0x1ea7bee5/defcon_badge_2026/defcon_badge_main/defcon_badge_main.stl

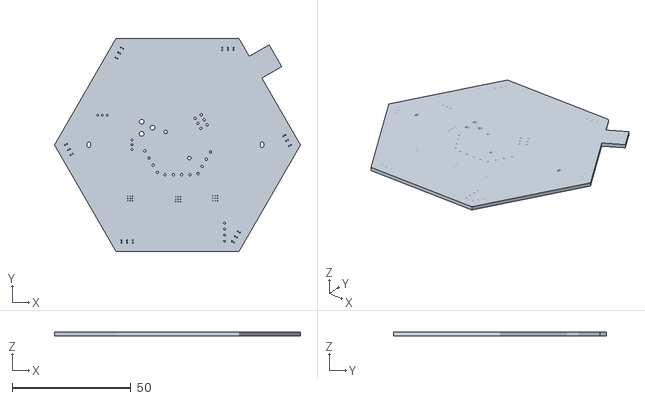
[picture p1: CAD file, 2026-06-07]
defcon_badge_main/defcon_badge_main.stl
103.5 x 89.6 x 1.51
