0x1ea7bee5/defcon_badge_2026/external_footprints/1043P/1043P.step

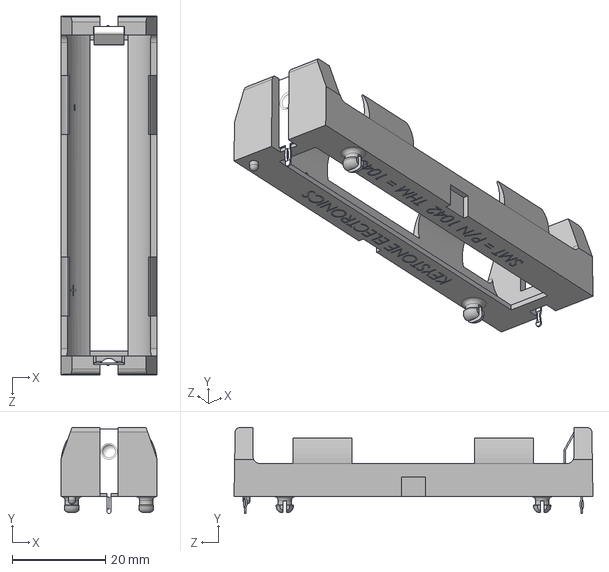
[picture p2: CAD file, 2026-02-23]
external_footprints/1043P/1043P.step
20.7 x 18.5 x 77.1 mm
