0x1ea7bee5/defcon_badge_2026/external_footprints/BK-18650-PC2/BK-18650-PC2.step

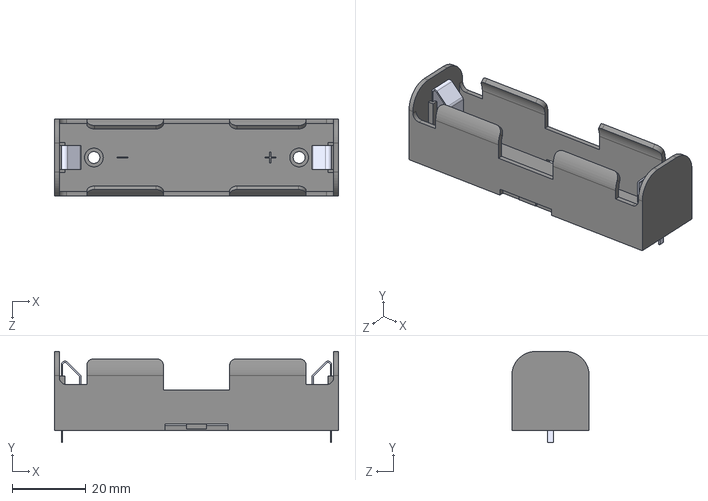
[picture p3: CAD file, 2026-03-09]
external_footprints/BK-18650-PC2/BK-18650-PC2.step
77.0 x 24.7 x 21.0 mm
