0x1ea7bee5/defcon_badge_2026/external_footprints/DRIVER-A4988SETTR-T_QFN28_/DRIVER-A4988SETTR-T_QFN28_.step

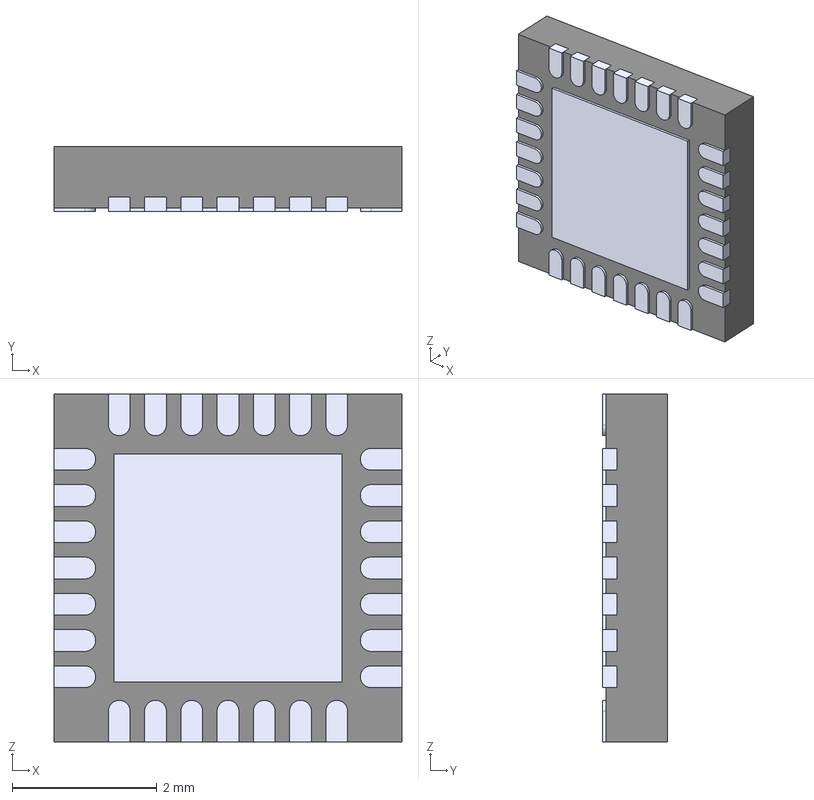
[picture p4: CAD file, 2026-02-22]
external_footprints/DRIVER-A4988SETTR-T_QFN28_/DRIVER-A4988SETTR-T_QFN28_.step
4.80 x 0.9 x 4.80 mm
Body_Solid1
Body001_Solid1
Array_Solid1 x 7
Array001_Solid2 x 6
Body002_Solid1
Array002_Solid1 x 7
Array003_Solid2 x 6
Body003_Solid1
Body004_Solid1
