0x1ea7bee5/defcon_badge_2026/external_footprints/ESP32-C5-WROOM-1U PCB Footprint_0.dxf

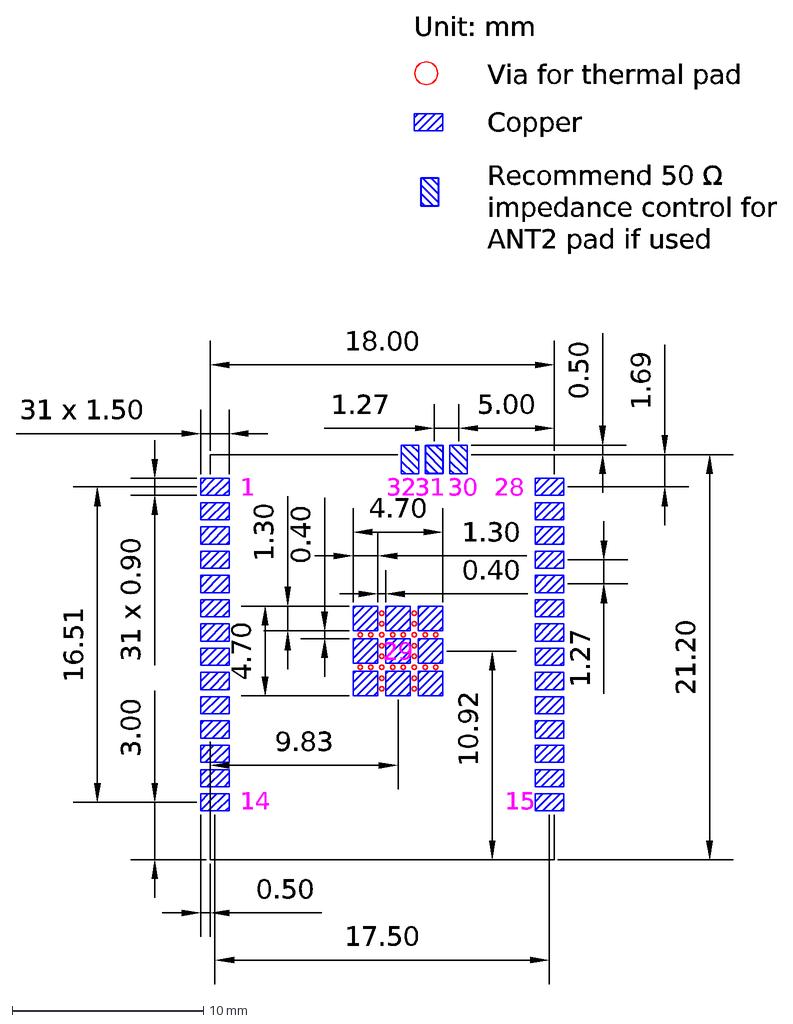
[picture p5: CAD file, 2026-02-21]
external_footprints/ESP32-C5-WROOM-1U PCB Footprint_0.dxf
1
28
Unit: mm
Copper
Via for thermal pad
14
15
1.27
31 x 1.50
31 x 0.90
3.00
16.51
17.50
1.30
0.40
4.70
18.00
0.50
9.83
10.92
30
31
32
1.69
21.20
5.00
Recommend 50 Ω impedance control for ANT2 pad if used
29
