0x1ea7bee5/defcon_badge_2026/external_footprints/SS24FL/SS24FL.step

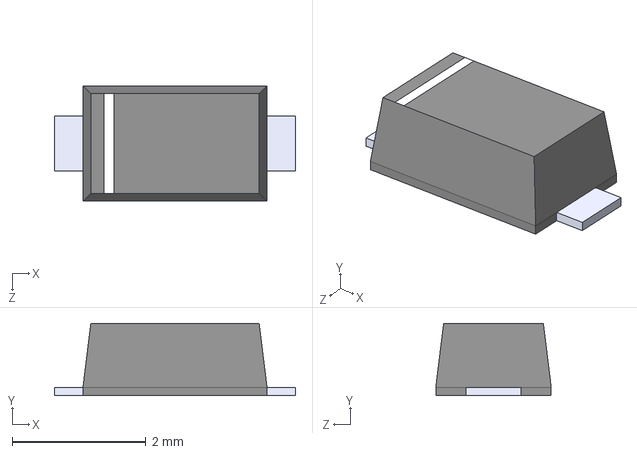
[picture p6: CAD file, 2026-02-23]
external_footprints/SS24FL/SS24FL.step
3.60 x 1.08 x 1.72 mm
