0x1ea7bee5/defcon_badge_2026/external_footprints/WCAP-ASLI_6.3X5.5/WCAP-ASLI_6.3X5.5.step

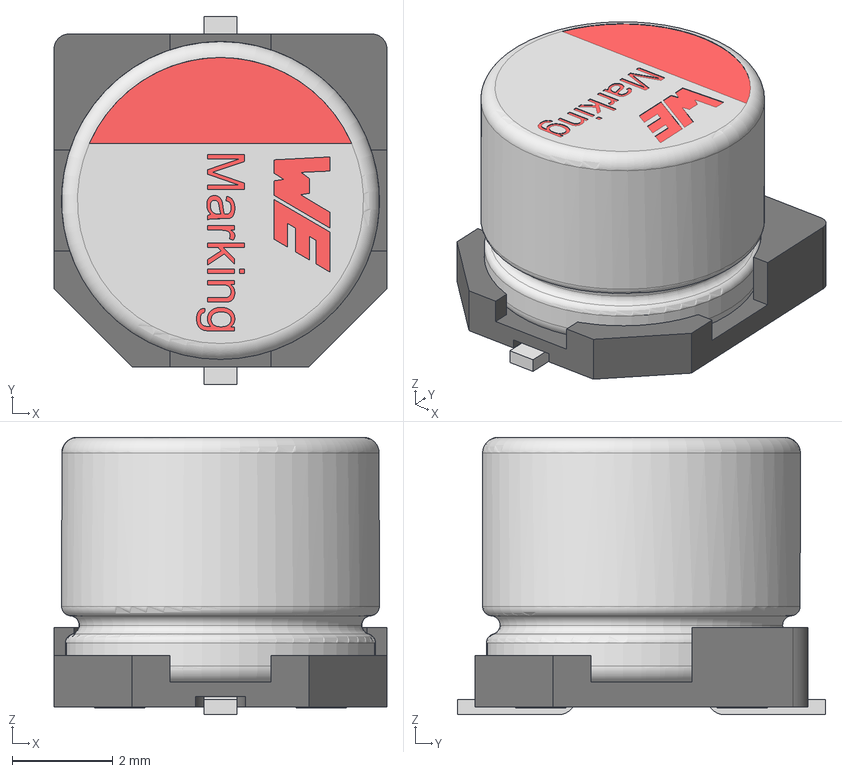
[picture p7: CAD file, 2026-02-23]
external_footprints/WCAP-ASLI_6.3X5.5/WCAP-ASLI_6.3X5.5.step
6.60 x 7.30 x 5.50 mm
capicitor_6.3x5.5x2.2
Base_Φ6_3Capacitor
