0x1ea7bee5/defcon_badge_2026/external_footprints/ESP32-C5-WROOM-1U_V1_1_20250619_0.STEP

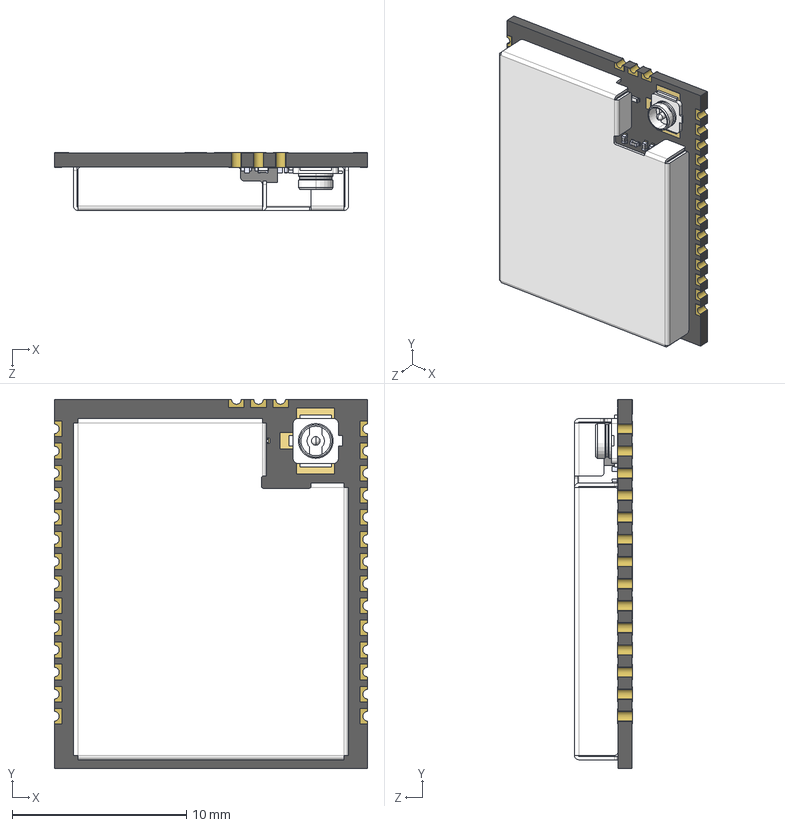
[picture p8: CAD file, 2026-02-21]
external_footprints/ESP32-C5-WROOM-1U_V1_1_20250619_0.STEP
18.0 x 21.2 x 3.34 mm
uid__9223372036872583655_3
XTAL2016.xtd_3
placementOutline_2_3
I-IPEX.xtd_3
C0201_20210301.xtd_3 x 23
C0402_20210301.xtd_3 x 3
ESP32_6x6_20210301.xtd_3
SOP8_rev1_20210308.xtd_3
LFD182G45MJ5D658.xtd_3
L0201_20210301.xtd_3 x 4
SOD882.xtd_3
Imported_3
pad-0.8mm_1 x 31
ShieldBox_ESP32-C5-WROOM-1U_V1.0_20241022_1
R0201_20210301.xtd_2 x 9
