0x1ea7bee5/defcon_badge_2026/external_footprints/10164359-00011LF/10164359-00011LF.step

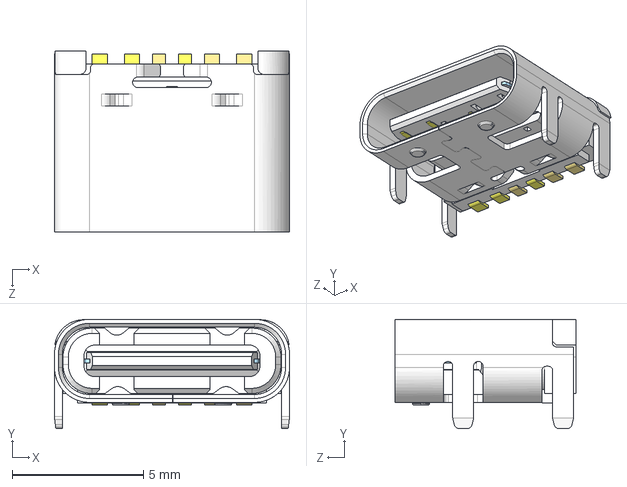
[picture p9: CAD file, 2026-03-07]
external_footprints/10164359-00011LF/10164359-00011LF.step
8.94 x 4.16 x 6.90 mm
