0x1ea7bee5/defcon_badge_2026/external_footprints/TPS61023DRLR/TPS61023DRLR.STEP

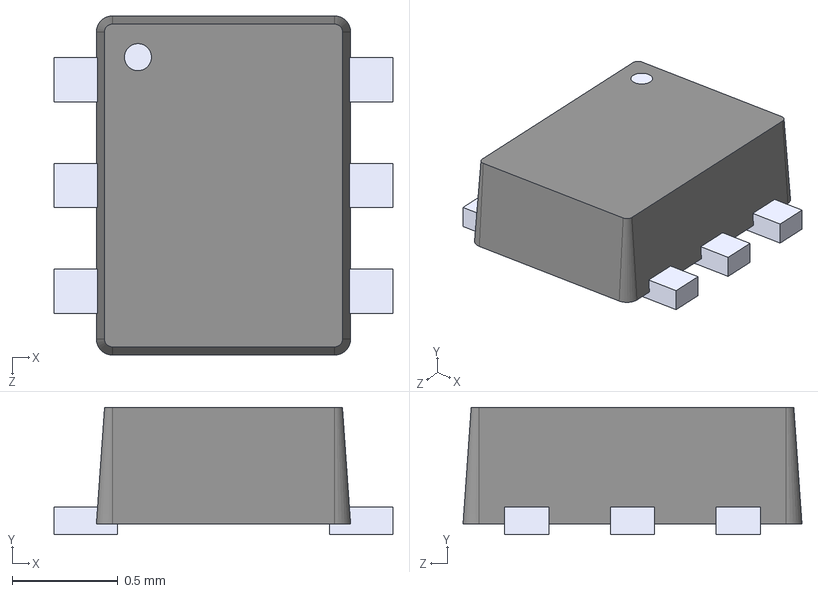
[picture p10: CAD file, 2026-02-21]
external_footprints/TPS61023DRLR/TPS61023DRLR.STEP
1.60 x 0.6 x 1.60 mm
