0x1ea7bee5/defcon_badge_2026/defcon_badge_main/defcon_badge_main.kicad_pcb

## KiCad design defcon_badge_main/defcon_badge_main.kicad_pcb (2026-06-07)

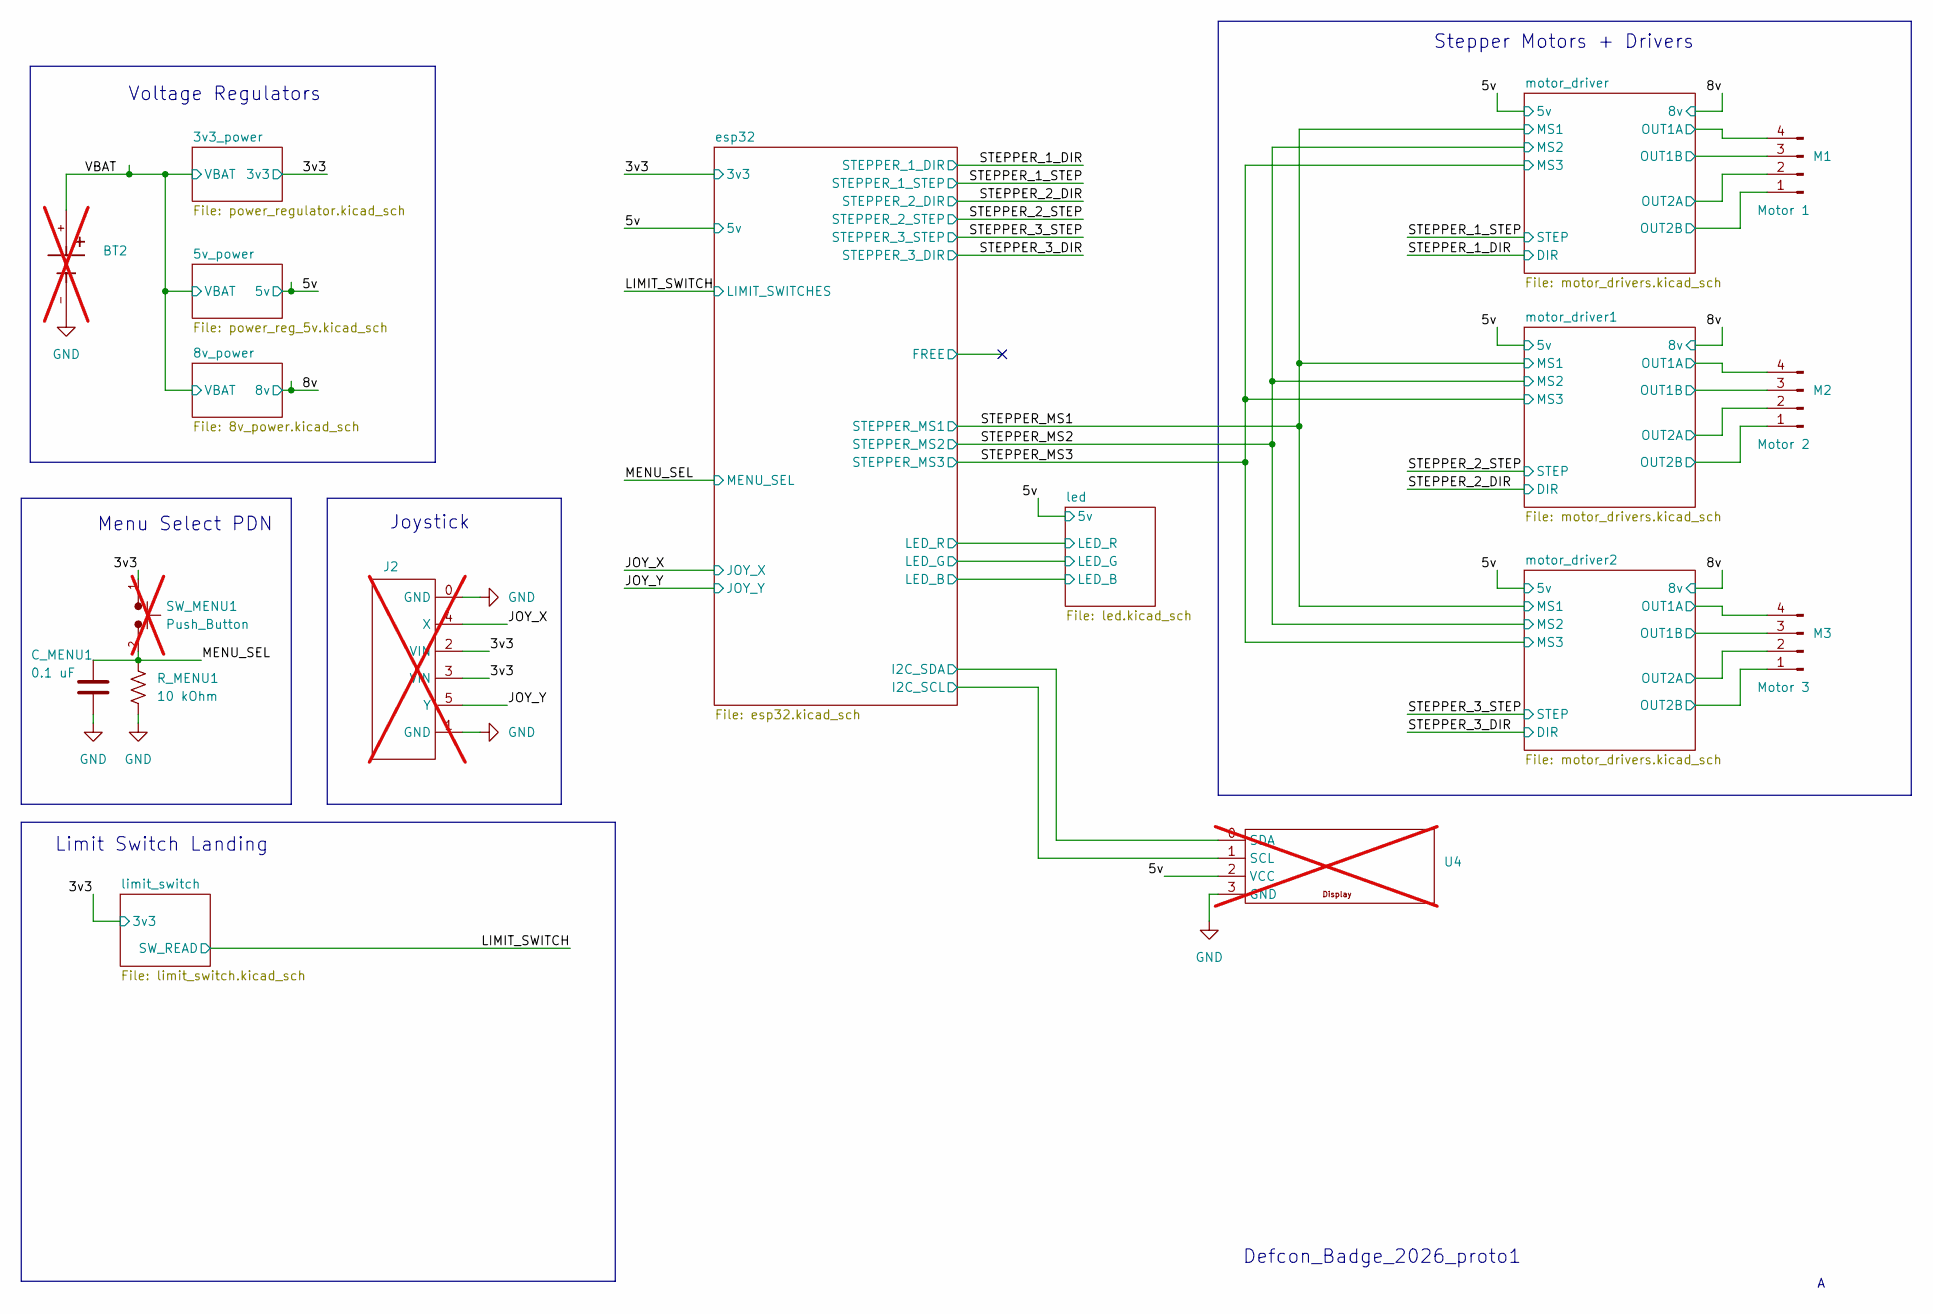
[picture p13: schematic defcon_badge_main.kicad_sch]

Parts:
BT2: BK-18650-PC2; BAT_BK-18650-PC2; PARTREV F; not fitted
C_MENU1: 0.1 uF; R_0402_1005Metric_Pad0.72x0.64mm_HandSolder_MINE; Rating 16V; MPN GMC10X7R104M16NTD
J2: joystick; not fitted
M1: Motor 1; motor_pins
M2: Motor 2; motor_pins
M3: Motor 3; motor_pins
R_MENU1: 10 kOhm; R_0805_2012Metric_Pad1.20x1.40mm_HandSolder_MINE; MPN RM10F1002CT
SW_MENU1: Push_Button; SW_SPST_PTS645; not fitted
U4: display; not fitted

Connections:
/3v3: J2.2 (VIN), J2.3 (VIN), SW_MENU1.1; also elsewhere on the board
/5v: U4.2 (VCC); also elsewhere on the board
/JOY_X: J2.4 (X); also elsewhere on the board
/JOY_Y: J2.5 (Y); also elsewhere on the board
/MENU_SEL: C_MENU1.2, R_MENU1.1, SW_MENU1.2; also elsewhere on the board
/VBAT: BT2.+; also elsewhere on the board
/esp32/I2C_SCL: U4.1 (SCL); also elsewhere on the board
/esp32/I2C_SDA: U4.0 (SDA); also elsewhere on the board
/motor_driver1/OUT1A: M2.4; also elsewhere on the board
/motor_driver1/OUT1B: M2.3; also elsewhere on the board
/motor_driver1/OUT2A: M2.2; also elsewhere on the board
/motor_driver1/OUT2B: M2.1; also elsewhere on the board
/motor_driver2/OUT1A: M3.4; also elsewhere on the board
/motor_driver2/OUT1B: M3.3; also elsewhere on the board
/motor_driver2/OUT2A: M3.2; also elsewhere on the board
/motor_driver2/OUT2B: M3.1; also elsewhere on the board
/motor_driver/OUT1A: M1.4; also elsewhere on the board
/motor_driver/OUT1B: M1.3; also elsewhere on the board
/motor_driver/OUT2A: M1.2; also elsewhere on the board
/motor_driver/OUT2B: M1.1; also elsewhere on the board
GND: BT2.-, C_MENU1.1, J2.0 (GND), J2.1 (GND), R_MENU1.2, U4.3 (GND); also elsewhere on the board

Notes on the sheet:
Stepper Motors + Drivers
Defcon_Badge_2026_proto1
Voltage Regulators
Joystick
Menu Select PDN
Limit Switch Landing

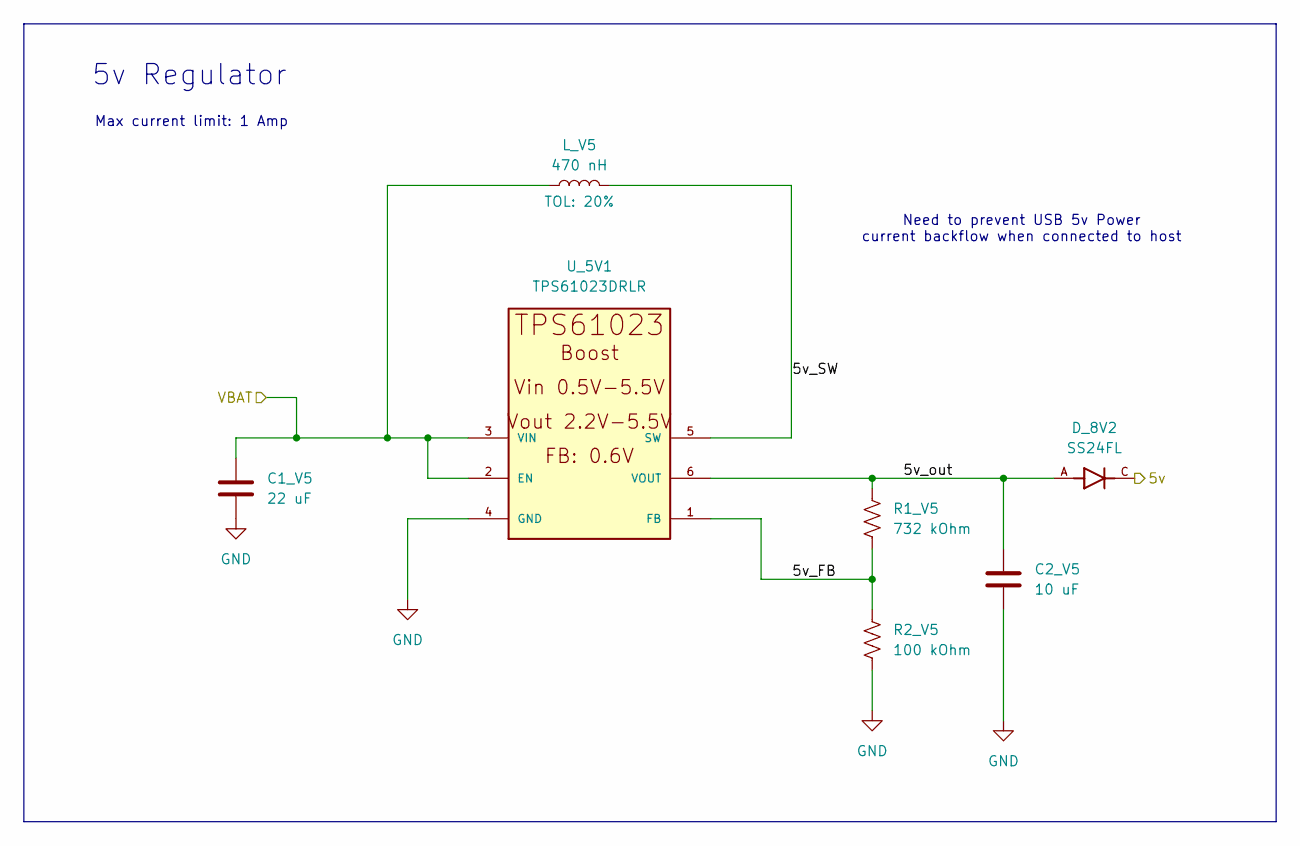
[picture p14: schematic power_reg_5v.kicad_sch]

Parts:
C1_V5: 22 uF; R_0805_2012Metric_Pad1.20x1.40mm_HandSolder_MINE; Rating 16V; MPN GMC21X5R226K16NT
C2_V5: 10 uF; R_0805_2012Metric_Pad1.20x1.40mm_HandSolder_MINE; Rating 16V; MPN GMC21X5R106K16NT
D_8V2: SS24FL; SODFL3617X108N; PARTREV A
L_V5: 470 nH; L_Neosid_SMS-ME3010; MPN 74479288147
R1_V5: 732 kOhm; R_1206_3216Metric_Pad1.30x1.75mm_HandSolder_MINE; MPN RM12F7323CT
R2_V5: 100 kOhm; R_1206_3216Metric_Pad1.30x1.75mm_HandSolder_MINE; MPN RM12F1003CT
U_5V1: TPS61023DRLR; SOT563-ORI; MPN TPS61023DRLR

Connections:
/5v: D_8V2.C; also elsewhere on the board
/5v_power/5v_FB: R1_V5.2, R2_V5.1, U_5V1.1 (FB)
/5v_power/5v_SW: L_V5.2, U_5V1.5 (SW)
/5v_power/5v_out: C2_V5.1, D_8V2.A, R1_V5.1, U_5V1.6 (VOUT)
/VBAT: C1_V5.1, L_V5.1, U_5V1.2 (EN), U_5V1.3 (VIN); also elsewhere on the board
GND: C1_V5.2, C2_V5.2, R2_V5.2, U_5V1.4 (GND); also elsewhere on the board

Notes on the sheet:
Max current limit: 1 Amp
Need to prevent USB 5v Power current backflow when connected to host
5v Regulator

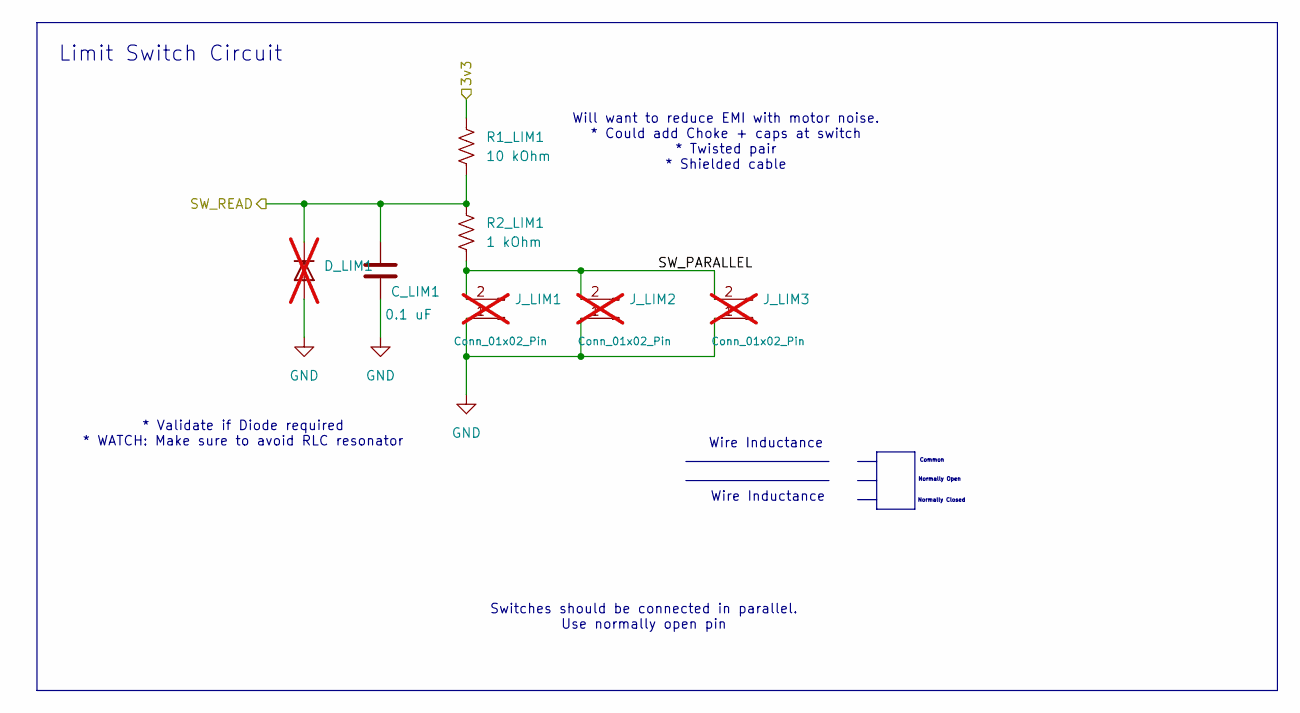
[picture p15: schematic limit_switch.kicad_sch]

Parts:
C_LIM1: 0.1 uF; R_0603_1608Metric_Pad0.98x0.95mm_HandSolder_MINE; Rating 16V; MPN GMC10X7R104M16NTD
D_LIM1: SOD-123; MPN 1N4148W-TP; not fitted
J_LIM1, J_LIM2, J_LIM3: Conn_01x02_Pin; pad_limit_switch; not fitted
R1_LIM1: 10 kOhm; R_0805_2012Metric_Pad1.20x1.40mm_HandSolder_MINE; MPN RM10F1002CT
R2_LIM1: 1 kOhm; R_1206_3216Metric_Pad1.30x1.75mm_HandSolder_MINE; MPN RMCS1206JT1K00

Connections:
/3v3: R1_LIM1.1; also elsewhere on the board
/LIMIT_SWITCH: C_LIM1.2, D_LIM1.1 (K), R1_LIM1.2, R2_LIM1.1; also elsewhere on the board
/limit_switch/SW_PARALLEL: J_LIM1.2, J_LIM2.2, J_LIM3.2, R2_LIM1.2
GND: C_LIM1.1, D_LIM1.2 (A), J_LIM1.1, J_LIM2.1, J_LIM3.1; also elsewhere on the board

Notes on the sheet:
* Validate if Diode required * WATCH: Make sure to avoid RLC resonator
Wire Inductance
Common
Normally Closed
Will want to reduce EMI with motor noise. * Could add Choke + caps at switch * Twisted pair * Shielded cable
Switches should be connected in parallel. Use normally open pin
Normally Open
Limit Switch Circuit

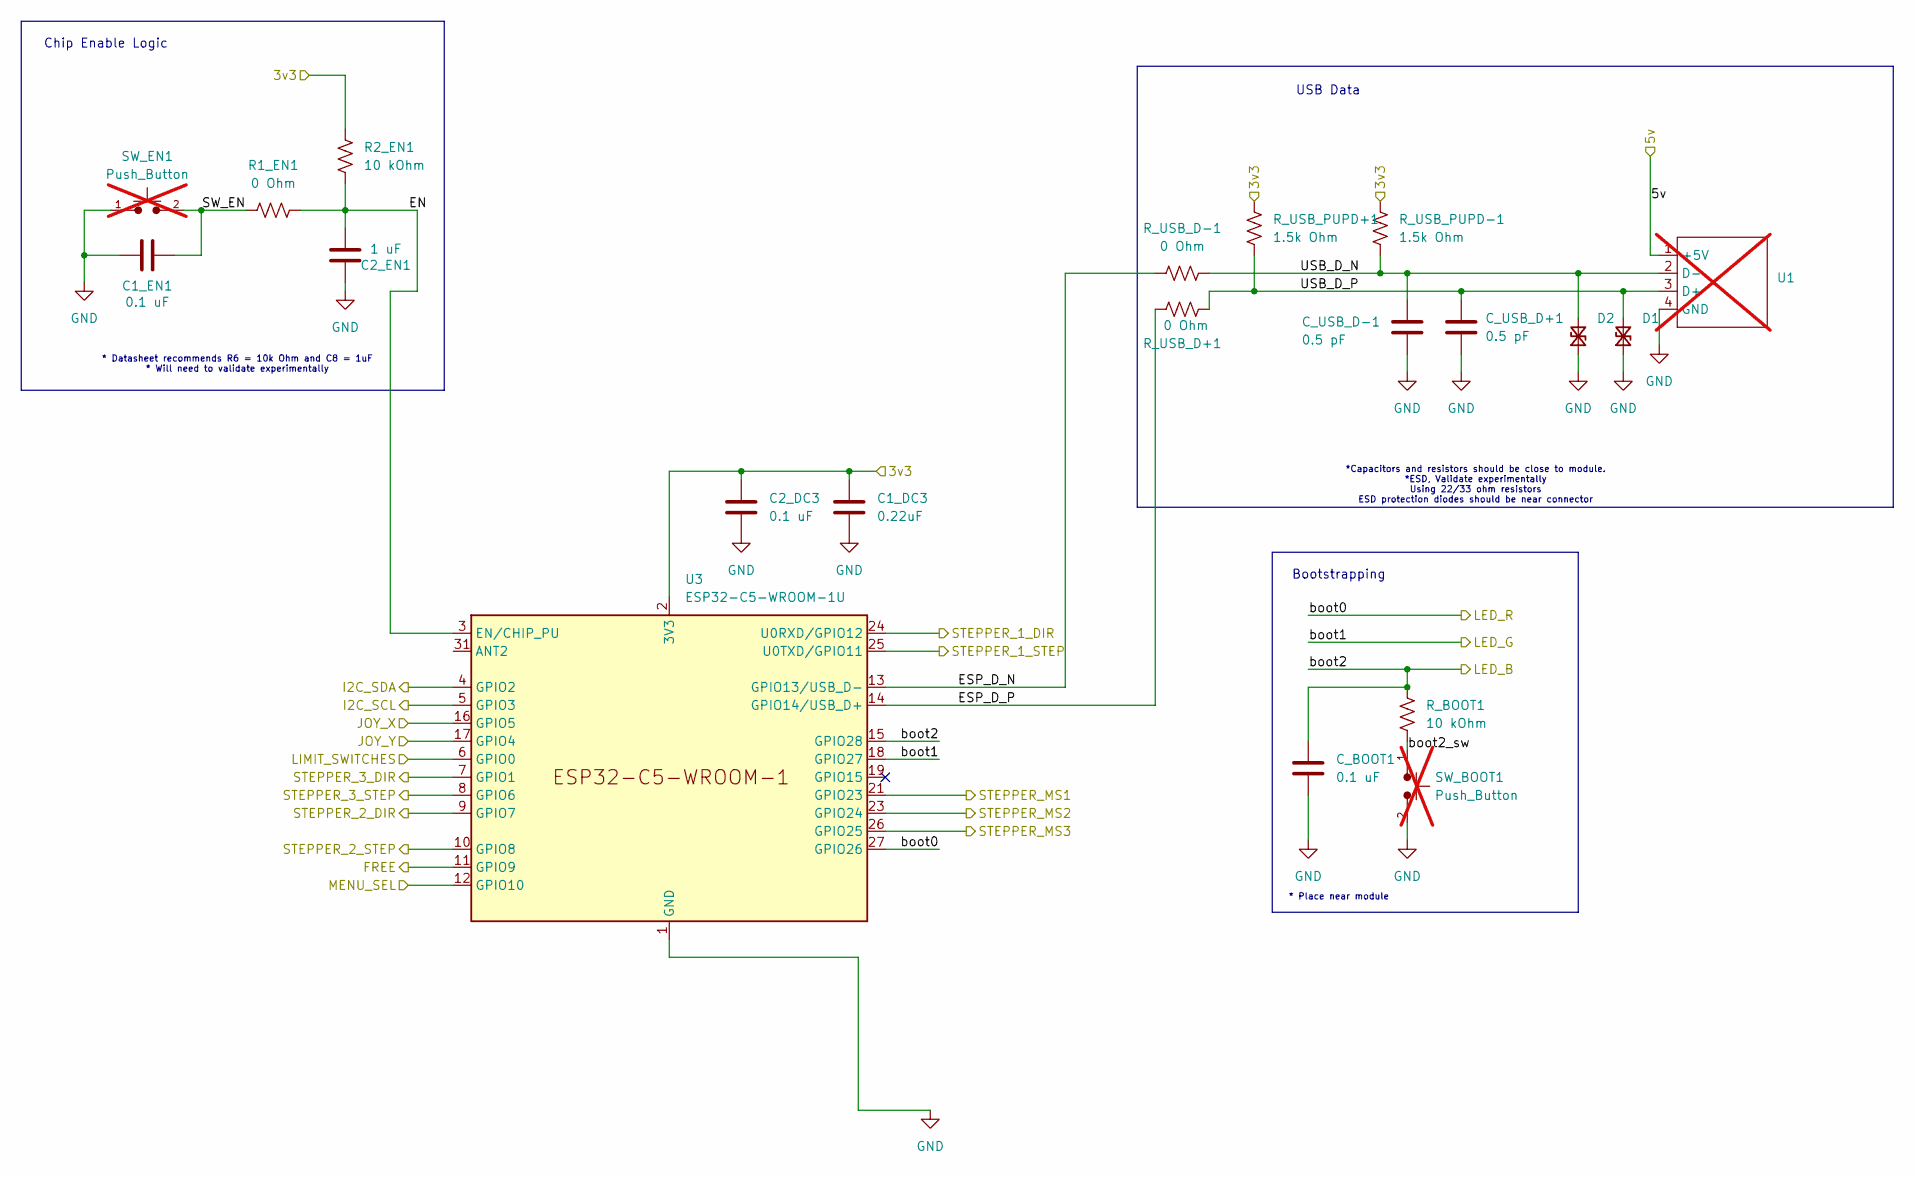
[picture p16: schematic esp32.kicad_sch]

Parts:
C1_DC3: 0.22uF; R_0805_2012Metric_Pad1.20x1.40mm_HandSolder_MINE; Rating 16V; MPN GMC10X5R224K25NT
C1_EN1, C2_DC3: 0.1 uF; R_0603_1608Metric_Pad0.98x0.95mm_HandSolder_MINE; Rating 16V; MPN GMC10X7R104M16NTD
C2_EN1: 1 uF; R_0805_2012Metric_Pad1.20x1.40mm_HandSolder_MINE; MPN GMC21X5R105K16NT
C_BOOT1: 0.1 uF; R_0603_1608Metric_Pad0.98x0.95mm_HandSolder_MINE; Rating 16V; MPN GMC10X7R104M16NTD
C_USB_D+1: 0.5 pF; R_0402_1005Metric_Pad0.72x0.64mm_HandSolder_MINE; Rating 16V; MPN GMC04CG0R5C50NT
C_USB_D-1: 0.5 pF; R_0402_1005Metric_Pad0.72x0.64mm_HandSolder_MINE; Rating 16V; MPN GMC04CG0R5C50NT
D1, D2: PESD0402; R_0402_1005Metric_Pad0.72x0.64mm_HandSolder_MINE; Rating 14VWM/40VC; MPN CES10402V05B0DG
R1_EN1: 0 Ohm; R_0603_1608Metric_Pad0.98x0.95mm_HandSolder_MINE; MPN RM06J000CT
R2_EN1: 10 kOhm; R_0805_2012Metric_Pad1.20x1.40mm_HandSolder_MINE; MPN RM10F1002CT
R_BOOT1: 10 kOhm; R_0805_2012Metric_Pad1.20x1.40mm_HandSolder_MINE; MPN RM10F1002CT
R_USB_D+1: 0 Ohm; R_0402_1005Metric_Pad0.72x0.64mm_HandSolder_MINE; MPN RM04J000CT
R_USB_D-1: 0 Ohm; R_0402_1005Metric_Pad0.72x0.64mm_HandSolder_MINE; MPN RM04J000CT
R_USB_PUPD+1: 1.5k Ohm; R_0402_1005Metric_Pad0.72x0.64mm_HandSolder_MINE; MPN RM04J152CT
R_USB_PUPD-1: 1.5k Ohm; R_0402_1005Metric_Pad0.72x0.64mm_HandSolder_MINE; MPN RM04J152CT
SW_BOOT1: Push_Button; SW_SPST_PTS810; not fitted
SW_EN1: Push_Button; SW_SPST_PTS810; not fitted
U1: usb_typea_boardedge; not fitted
U3: ESP32-C5-WROOM-1U; MPN ESP32-C5-WROOM-1U-N8R8

Connections:
/3v3: C1_DC3.1, C2_DC3.1, R2_EN1.2, R_USB_PUPD+1.2, R_USB_PUPD-1.2, U3.2 (3V3); also elsewhere on the board
/5v: U1.1 (+5V); also elsewhere on the board
/JOY_X: U3.16 (GPIO5); also elsewhere on the board
/JOY_Y: U3.17 (GPIO4); also elsewhere on the board
/LIMIT_SWITCH: U3.6 (GPIO0); also elsewhere on the board
/MENU_SEL: U3.12 (GPIO10); also elsewhere on the board
/STEPPER_1_DIR: U3.24 (U0RXD/GPIO12); also elsewhere on the board
/STEPPER_1_STEP: U3.25 (U0TXD/GPIO11); also elsewhere on the board
/STEPPER_2_DIR: U3.9 (GPIO7); also elsewhere on the board
/STEPPER_2_STEP: U3.10 (GPIO8); also elsewhere on the board
/STEPPER_3_DIR: U3.7 (GPIO1); also elsewhere on the board
/STEPPER_3_STEP: U3.8 (GPIO6); also elsewhere on the board
/STEPPER_MS1: U3.21 (GPIO23); also elsewhere on the board
/STEPPER_MS2: U3.23 (GPIO24); also elsewhere on the board
/STEPPER_MS3: U3.26 (GPIO25); also elsewhere on the board
/esp32/EN: C2_EN1.1, R1_EN1.2, R2_EN1.1, U3.3 (EN/CHIP_PU)
/esp32/ESP_D_N: R_USB_D-1.1, U3.13 (GPIO13/USB_D-)
/esp32/ESP_D_P: R_USB_D+1.2, U3.14 (GPIO14/USB_D+)
/esp32/FREE: U3.11 (GPIO9)
/esp32/I2C_SCL: U3.5 (GPIO3); also elsewhere on the board
/esp32/I2C_SDA: U3.4 (GPIO2); also elsewhere on the board
/esp32/SW_EN: C1_EN1.1, R1_EN1.1, SW_EN1.2
/esp32/USB_D_N: C_USB_D-1.1, D2.2 (A2), R_USB_D-1.2, R_USB_PUPD-1.1, U1.2 (D-)
/esp32/USB_D_P: C_USB_D+1.1, D1.2 (A2), R_USB_D+1.1, R_USB_PUPD+1.1, U1.3 (D+)
/esp32/boot0: U3.27 (GPIO26); also elsewhere on the board
/esp32/boot1: U3.18 (GPIO27); also elsewhere on the board
/esp32/boot2: C_BOOT1.1, R_BOOT1.2, U3.15 (GPIO28); also elsewhere on the board
/esp32/boot2_sw: R_BOOT1.1, SW_BOOT1.1
GND: C1_DC3.2, C1_EN1.2, C2_DC3.2, C2_EN1.2, C_BOOT1.2, C_USB_D+1.2, C_USB_D-1.2, D1.1 (A1), D2.1 (A1), SW_BOOT1.2, SW_EN1.1, U1.4 (GND), U3.1 (GND), U3.28 (GND), U3.29 (GND), U3.30 (GND), U3.32 (GND); also elsewhere on the board

Notes on the sheet:
Chip Enable Logic
USB Data
* Place near module
* Datasheet recommends R6 = 10k Ohm and C8 = 1uF * Will need to validate experimentally
*Capacitors and resistors should be close to module. *ESD, Validate experimentally Using 22/33 ohm resistors ESD protection diodes should be near connector
Bootstrapping

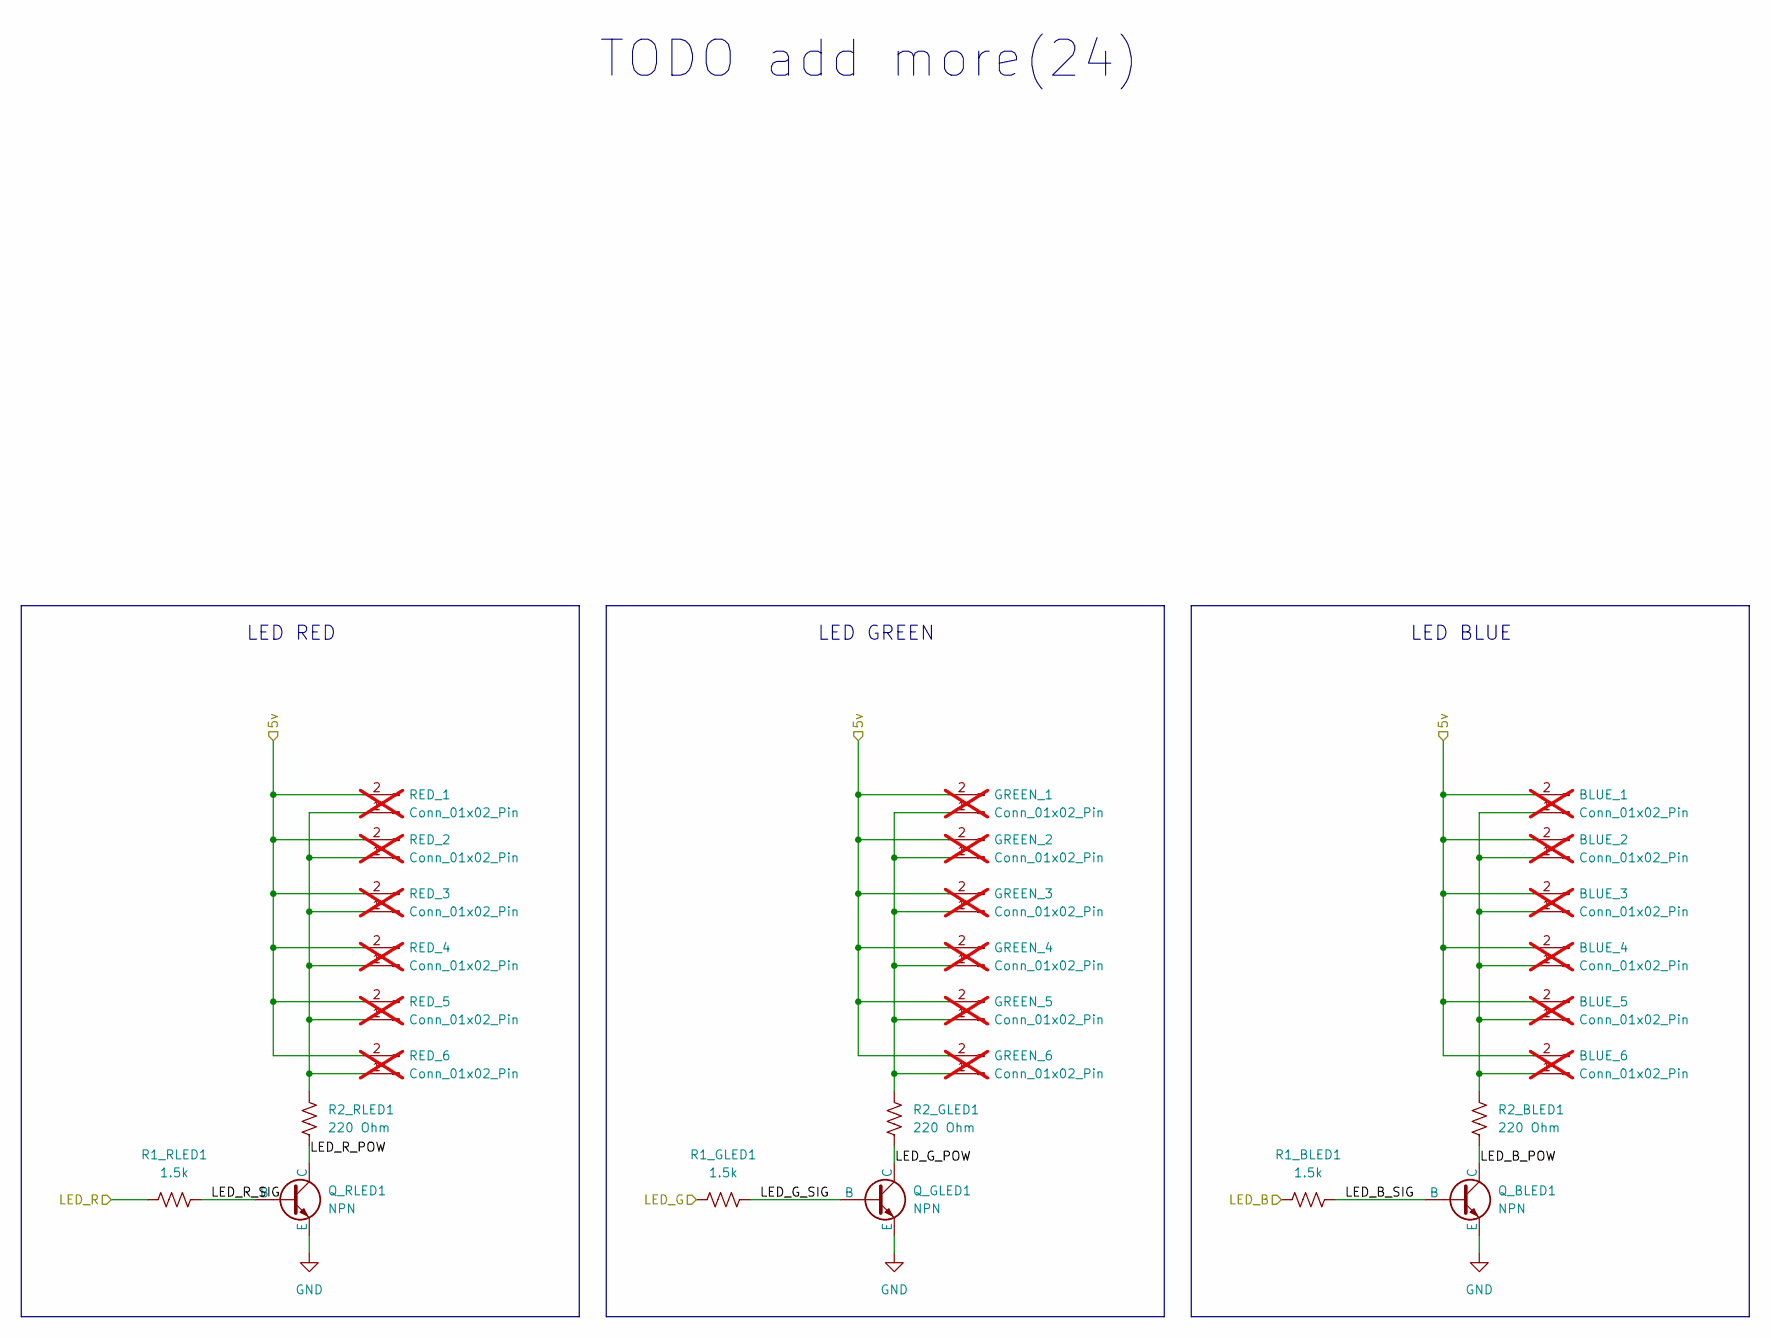
[picture p17: schematic led.kicad_sch]

Parts:
BLUE_1, BLUE_2, BLUE_3, BLUE_4, BLUE_5, BLUE_6: Conn_01x02_Pin; PinHeader_1x02_P1.00mm_Vertical; not fitted
GREEN_1, GREEN_2, GREEN_3, GREEN_4, GREEN_5, GREEN_6: Conn_01x02_Pin; PinHeader_1x02_P1.00mm_Vertical; not fitted
Q_BLED1: NPN; SOT-23-3; MPN MMUN2211LT1G
Q_GLED1: NPN; SOT-23-3; MPN MMUN2211LT1G
Q_RLED1: NPN; SOT-23-3; MPN MMUN2211LT1G
R1_BLED1, R1_GLED1, R1_RLED1: 1.5k; R_0805_2012Metric_Pad1.20x1.40mm_HandSolder; MPN RM10F1501CT
R2_BLED1, R2_GLED1, R2_RLED1: 220 Ohm; R_0805_2012Metric_Pad1.20x1.40mm_HandSolder; MPN RM10F2200CT
RED_1, RED_2, RED_3, RED_4, RED_5, RED_6: Conn_01x02_Pin; PinHeader_1x02_P1.00mm_Vertical; not fitted

Connections:
/5v: BLUE_1.2, BLUE_2.2, BLUE_3.2, BLUE_4.2, BLUE_5.2, BLUE_6.2, GREEN_1.2, GREEN_2.2, GREEN_3.2, GREEN_4.2, GREEN_5.2, GREEN_6.2, RED_1.2, RED_2.2, RED_3.2, RED_4.2, RED_5.2, RED_6.2; also elsewhere on the board
/esp32/boot0: R1_RLED1.1; also elsewhere on the board
/esp32/boot1: R1_GLED1.1; also elsewhere on the board
/esp32/boot2: R1_BLED1.1; also elsewhere on the board
/led/LED_B_POW: Q_BLED1.1 (C), R2_BLED1.2
/led/LED_B_SIG: Q_BLED1.2 (B), R1_BLED1.2
/led/LED_G_POW: Q_GLED1.1 (C), R2_GLED1.2
/led/LED_G_SIG: Q_GLED1.2 (B), R1_GLED1.2
/led/LED_R_POW: Q_RLED1.1 (C), R2_RLED1.2
/led/LED_R_SIG: Q_RLED1.2 (B), R1_RLED1.2
GND: Q_BLED1.3 (E), Q_GLED1.3 (E), Q_RLED1.3 (E); also elsewhere on the board
unnamed: BLUE_1.1, BLUE_2.1, BLUE_3.1, BLUE_4.1, BLUE_5.1, BLUE_6.1, R2_BLED1.1
unnamed: GREEN_1.1, GREEN_2.1, GREEN_3.1, GREEN_4.1, GREEN_5.1, GREEN_6.1, R2_GLED1.1
unnamed: R2_RLED1.1, RED_1.1, RED_2.1, RED_3.1, RED_4.1, RED_5.1, RED_6.1

Notes on the sheet:
TODO add more(24)
LED RED
LED BLUE
LED GREEN

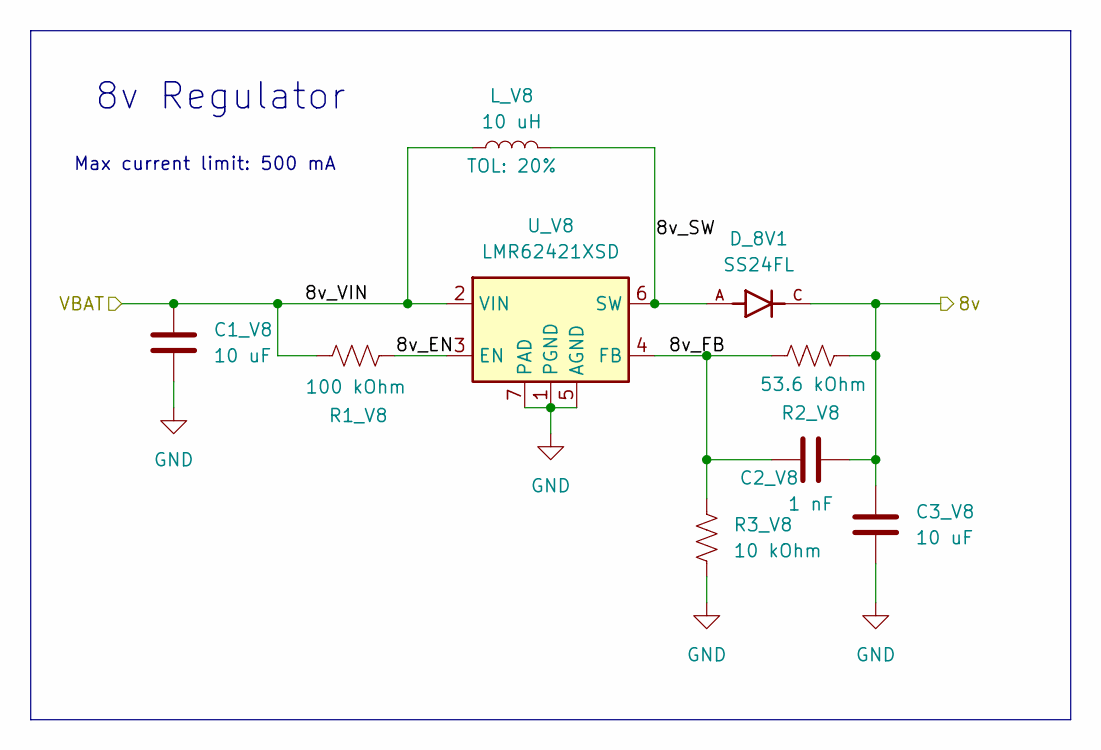
[picture p18: schematic 8v_power.kicad_sch]

Parts:
C1_V8, C3_V8: 10 uF; R_0805_2012Metric_Pad1.20x1.40mm_HandSolder_MINE; Rating 16V; MPN GMC21X5R106K16NT
C2_V8: 1 nF; R_0603_1608Metric_Pad0.98x0.95mm_HandSolder_MINE; MPN GMC10X7R102K16NT
D_8V1: SS24FL; SODFL3617X108N; PARTREV A
L_V8: 10 uH; 0_1uh; MPN 74438357100
R1_V8: 100 kOhm; R_1206_3216Metric_Pad1.30x1.75mm_HandSolder_MINE; MPN RM12F1003CT
R2_V8: 53.6 kOhm; R_1206_3216Metric_Pad1.30x1.75mm_HandSolder_MINE; MPN RM12F5362CT
R3_V8: 10 kOhm; R_1206_3216Metric_Pad1.30x1.75mm_HandSolder_MINE; MPN RM12F1002CT
U_V8: LMR62421XSD; WSON-6-1EP_3x3mm_P0.95mm; MPN LMR62421XSD/NOPB

Connections:
/8v: C2_V8.2, C3_V8.1, D_8V1.C, R2_V8.1; also elsewhere on the board
/8v_power/8v_EN: R1_V8.1, U_V8.3 (EN)
/8v_power/8v_FB: C2_V8.1, R2_V8.2, R3_V8.2, U_V8.4 (FB)
/8v_power/8v_SW: D_8V1.A, L_V8.2, U_V8.6 (SW)
/VBAT: C1_V8.1, L_V8.1, R1_V8.2, U_V8.2 (VIN); also elsewhere on the board
GND: C1_V8.2, C3_V8.2, R3_V8.1, U_V8.1 (PGND), U_V8.5 (AGND), U_V8.7 (PAD); also elsewhere on the board

Notes on the sheet:
Max current limit: 500 mA
8v Regulator

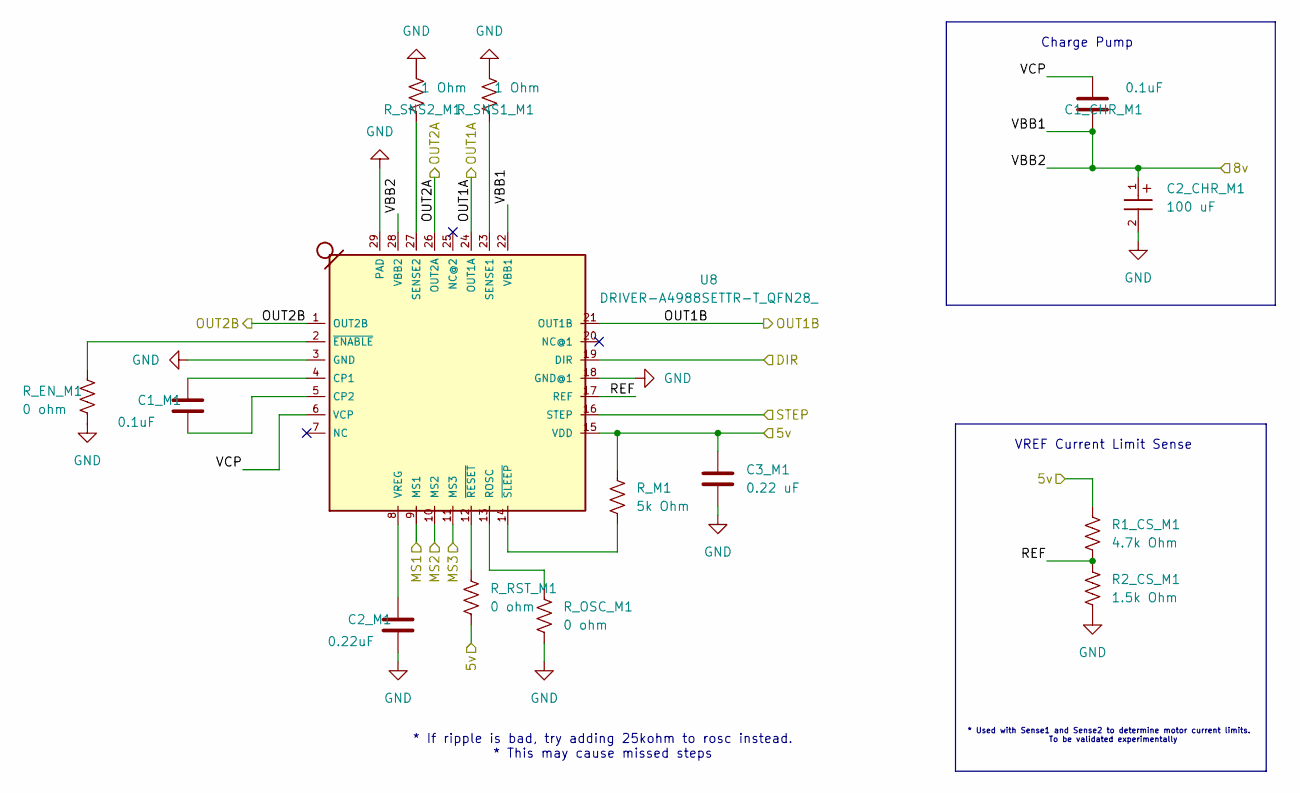
[picture p19: schematic motor_drivers.kicad_sch]

Parts:
C1_CHR_M1, C1_M1: 0.1uF; R_0603_1608Metric_Pad0.98x0.95mm_HandSolder_MINE; Rating 16V; MPN GMC10X7R104M16NTD
C2_CHR_M1: 100 uF; WCAP-ASLI_6.3X5.5_DXL_; MPN 865080343009
C2_M1: 0.22uF; R_0603_1608Metric_Pad0.98x0.95mm_HandSolder_MINE; Rating 16V; MPN GMC10X5R224K25NT
C3_M1: 0.22 uF; R_0603_1608Metric_Pad0.98x0.95mm_HandSolder_MINE; Rating 16V; MPN GMC10X5R224K25NT
R1_CS_M1: 4.7k Ohm; R_0603_1608Metric_Pad0.98x0.95mm_HandSolder_MINE; MPN RM06J472CT
R2_CS_M1: 1.5k Ohm; R_0603_1608Metric_Pad0.98x0.95mm_HandSolder_MINE; MPN RM06F1501CT
R_EN_M1: 0 ohm; R_0603_1608Metric_Pad0.98x0.95mm_HandSolder_MINE; MPN RM06J000CT
R_M1: 5k Ohm; R_0603_1608Metric_Pad0.98x0.95mm_HandSolder_MINE; MPN MCT06030D5001BP500
R_OSC_M1: 0 ohm; R_0603_1608Metric_Pad0.98x0.95mm_HandSolder_MINE; MPN RM06J000CT
R_RST_M1: 0 ohm; R_0603_1608Metric_Pad0.98x0.95mm_HandSolder_MINE; MPN RM06J000CT
R_SNS1_M1, R_SNS2_M1: 1 Ohm; R_0603_1608Metric_Pad0.98x0.95mm_HandSolder_MINE; MPN RM06J1R0CT
U8: DRIVER-A4988SETTR-T_QFN28_; QFN28G_0.5-5X5MM; MPN A4988SETTR-T

Connections:
/5v: C3_M1.1, R1_CS_M1.1, R_M1.1, R_RST_M1.2, U8.15 (VDD); also elsewhere on the board
/8v: C1_CHR_M1.2, C2_CHR_M1.1, U8.22 (VBB1), U8.28 (VBB2); also elsewhere on the board
/STEPPER_1_DIR: U8.19 (DIR); also elsewhere on the board
/STEPPER_1_STEP: U8.16 (STEP); also elsewhere on the board
/STEPPER_MS1: U8.9 (MS1); also elsewhere on the board
/STEPPER_MS2: U8.10 (MS2); also elsewhere on the board
/STEPPER_MS3: U8.11 (MS3); also elsewhere on the board
/motor_driver/OUT1A: U8.24 (OUT1A); also elsewhere on the board
/motor_driver/OUT1B: U8.21 (OUT1B); also elsewhere on the board
/motor_driver/OUT2A: U8.26 (OUT2A); also elsewhere on the board
/motor_driver/OUT2B: U8.1 (OUT2B); also elsewhere on the board
/motor_driver/REF: R1_CS_M1.2, R2_CS_M1.1, U8.17 (REF)
/motor_driver/VCP: C1_CHR_M1.1, U8.6 (VCP)
GND: C2_CHR_M1.2, C2_M1.1, C3_M1.2, R2_CS_M1.2, R_EN_M1.2, R_OSC_M1.2, R_SNS1_M1.2, R_SNS2_M1.2, U8.3 (GND), U8.18 (GND@1), U8.29 (PAD); also elsewhere on the board
unnamed: C1_M1.2, U8.4 (CP1)
unnamed: C1_M1.1, U8.5 (CP2)
unnamed: R_OSC_M1.1, U8.13 (ROSC)
unnamed: R_SNS1_M1.1, U8.23 (SENSE1)
unnamed: R_SNS2_M1.1, U8.27 (SENSE2)
unnamed: C2_M1.2, U8.8 (VREG)
unnamed: R_EN_M1.1, U8.2 (~ENABLE)
unnamed: R_RST_M1.1, U8.12 (~RESET)
unnamed: R_M1.2, U8.14 (~SLEEP)

Parts of its further copies:
C1_CHR_M2, C1_CHR_M3, C1_M2, C1_M3: 0.1uF; R_0603_1608Metric_Pad0.98x0.95mm_HandSolder_MINE; Rating 16V; MPN GMC10X7R104M16NTD
C2_CHR_M2, C2_CHR_M3: 100 uF; WCAP-ASLI_6.3X5.5_DXL_; MPN 865080343009
C2_M2, C2_M3: 0.22uF; R_0603_1608Metric_Pad0.98x0.95mm_HandSolder_MINE; Rating 16V; MPN GMC10X5R224K25NT
C3_M2, C3_M3: 0.22 uF; R_0603_1608Metric_Pad0.98x0.95mm_HandSolder_MINE; Rating 16V; MPN GMC10X5R224K25NT
R1_CS_M2, R1_CS_M3: 4.7k Ohm; R_0603_1608Metric_Pad0.98x0.95mm_HandSolder_MINE; MPN RM06J472CT
R2_CS_M2, R2_CS_M3: 1.5k Ohm; R_0603_1608Metric_Pad0.98x0.95mm_HandSolder_MINE; MPN RM06F1501CT
R_EN_M2, R_EN_M3: 0 ohm; R_0603_1608Metric_Pad0.98x0.95mm_HandSolder_MINE; MPN RM06J000CT
R_M2, R_M3: 5k Ohm; R_0603_1608Metric_Pad0.98x0.95mm_HandSolder_MINE; MPN MCT06030D5001BP500
R_OSC_M2, R_OSC_M3: 0 ohm; R_0603_1608Metric_Pad0.98x0.95mm_HandSolder_MINE; MPN RM06J000CT
R_RST_M2, R_RST_M3: 0 ohm; R_0603_1608Metric_Pad0.98x0.95mm_HandSolder_MINE; MPN RM06J000CT
R_SNS1_M2, R_SNS1_M3, R_SNS2_M2, R_SNS2_M3: 1 Ohm; R_0603_1608Metric_Pad0.98x0.95mm_HandSolder_MINE; MPN RM06J1R0CT
U5, U6: DRIVER-A4988SETTR-T_QFN28_; QFN28G_0.5-5X5MM; MPN A4988SETTR-T

Connections of its further copies:
/5v: C3_M2.1, C3_M3.1, R1_CS_M2.1, R1_CS_M3.1, R_M2.1, R_M3.1, R_RST_M2.2, R_RST_M3.2, U5.15 (VDD), U6.15 (VDD); also elsewhere on the board
/8v: C1_CHR_M2.2, C1_CHR_M3.2, C2_CHR_M2.1, C2_CHR_M3.1, U5.22 (VBB1), U5.28 (VBB2), U6.22 (VBB1), U6.28 (VBB2); also elsewhere on the board
/STEPPER_2_DIR: U5.19 (DIR); also elsewhere on the board
/STEPPER_2_STEP: U5.16 (STEP); also elsewhere on the board
/STEPPER_3_DIR: U6.19 (DIR); also elsewhere on the board
/STEPPER_3_STEP: U6.16 (STEP); also elsewhere on the board
/STEPPER_MS1: U5.9 (MS1), U6.9 (MS1); also elsewhere on the board
/STEPPER_MS2: U5.10 (MS2), U6.10 (MS2); also elsewhere on the board
/STEPPER_MS3: U5.11 (MS3), U6.11 (MS3); also elsewhere on the board
/motor_driver1/OUT1A: U5.24 (OUT1A); also elsewhere on the board
/motor_driver1/OUT1B: U5.21 (OUT1B); also elsewhere on the board
/motor_driver1/OUT2A: U5.26 (OUT2A); also elsewhere on the board
/motor_driver1/OUT2B: U5.1 (OUT2B); also elsewhere on the board
/motor_driver1/REF: R1_CS_M2.2, R2_CS_M2.1, U5.17 (REF)
/motor_driver1/VCP: C1_CHR_M2.1, U5.6 (VCP)
/motor_driver2/OUT1A: U6.24 (OUT1A); also elsewhere on the board
/motor_driver2/OUT1B: U6.21 (OUT1B); also elsewhere on the board
/motor_driver2/OUT2A: U6.26 (OUT2A); also elsewhere on the board
/motor_driver2/OUT2B: U6.1 (OUT2B); also elsewhere on the board
/motor_driver2/REF: R1_CS_M3.2, R2_CS_M3.1, U6.17 (REF)
/motor_driver2/VCP: C1_CHR_M3.1, U6.6 (VCP)
GND: C2_CHR_M2.2, C2_CHR_M3.2, C2_M2.1, C2_M3.1, C3_M2.2, C3_M3.2, R2_CS_M2.2, R2_CS_M3.2, R_EN_M2.2, R_EN_M3.2, R_OSC_M2.2, R_OSC_M3.2, R_SNS1_M2.2, R_SNS1_M3.2, R_SNS2_M2.2, R_SNS2_M3.2, U5.3 (GND), U5.18 (GND@1), U5.29 (PAD), U6.3 (GND), U6.18 (GND@1), U6.29 (PAD); also elsewhere on the board
unnamed: C1_M2.2, U5.4 (CP1)
unnamed: C1_M2.1, U5.5 (CP2)
unnamed: R_OSC_M2.1, U5.13 (ROSC)
unnamed: R_SNS1_M2.1, U5.23 (SENSE1)
unnamed: R_SNS2_M2.1, U5.27 (SENSE2)
unnamed: C2_M2.2, U5.8 (VREG)
unnamed: R_EN_M2.1, U5.2 (~ENABLE)
unnamed: R_RST_M2.1, U5.12 (~RESET)
unnamed: R_M2.2, U5.14 (~SLEEP)
unnamed: C1_M3.2, U6.4 (CP1)
unnamed: C1_M3.1, U6.5 (CP2)
unnamed: R_OSC_M3.1, U6.13 (ROSC)
unnamed: R_SNS1_M3.1, U6.23 (SENSE1)
unnamed: R_SNS2_M3.1, U6.27 (SENSE2)
unnamed: C2_M3.2, U6.8 (VREG)
unnamed: R_EN_M3.1, U6.2 (~ENABLE)
unnamed: R_RST_M3.1, U6.12 (~RESET)
unnamed: R_M3.2, U6.14 (~SLEEP)

Notes on the sheet:
* Used with Sense1 and Sense2 to determine motor current limits. To be validated experimentally
VREF Current Limit Sense
Charge Pump
* If ripple is bad, try adding 25kohm to rosc instead. * This may cause missed steps

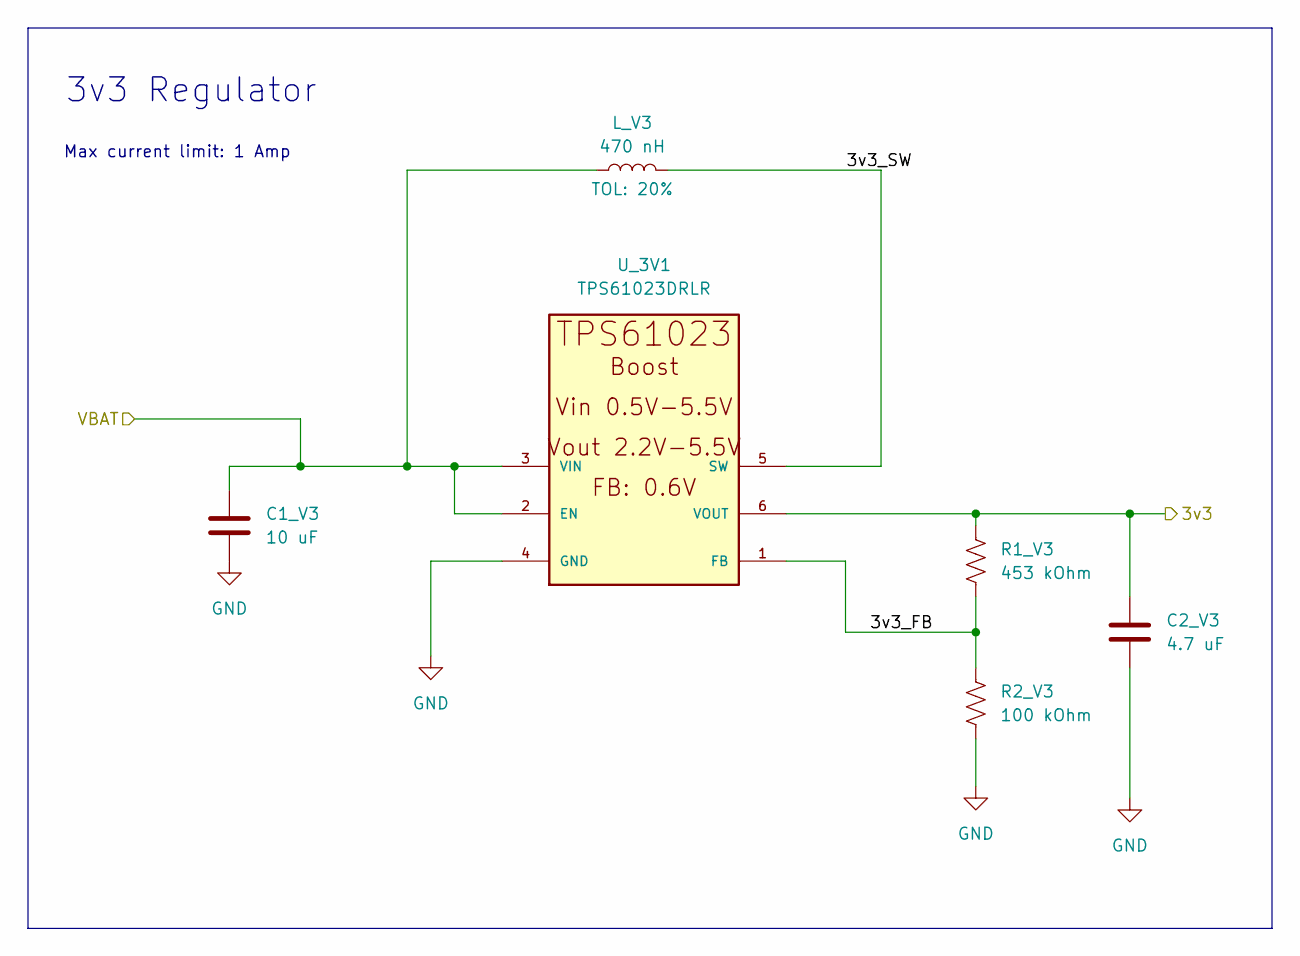
[picture p20: schematic power_regulator.kicad_sch]

Parts:
C1_V3: 10 uF; R_0805_2012Metric_Pad1.20x1.40mm_HandSolder_MINE; Rating 16V; MPN GMC21X5R106K16NT
C2_V3: 4.7 uF; R_0805_2012Metric_Pad1.20x1.40mm_HandSolder_MINE; Rating 16V; MPN GMC10Y5V475Z6R3NT
L_V3: 470 nH; L_Neosid_SMS-ME3010; MPN 74479288147
R1_V3: 453 kOhm; R_1206_3216Metric_Pad1.30x1.75mm_HandSolder_MINE; MPN RM12F4533CT
R2_V3: 100 kOhm; R_1206_3216Metric_Pad1.30x1.75mm_HandSolder_MINE; MPN RM12F1003CT
U_3V1: TPS61023DRLR; SOT563-ORI; MPN TPS61023DRLR

Connections:
/3v3: C2_V3.1, R1_V3.1, U_3V1.6 (VOUT); also elsewhere on the board
/3v3_power/3v3_FB: R1_V3.2, R2_V3.1, U_3V1.1 (FB)
/3v3_power/3v3_SW: L_V3.2, U_3V1.5 (SW)
/VBAT: C1_V3.1, L_V3.1, U_3V1.2 (EN), U_3V1.3 (VIN); also elsewhere on the board
GND: C1_V3.2, C2_V3.2, R2_V3.2, U_3V1.4 (GND); also elsewhere on the board

Notes on the sheet:
Max current limit: 1 Amp
3v3 Regulator
