0x1ea7bee5/defcon_badge_2026/defcon_badge_main/defcon_badge_main.kicad_pcb

## KiCad design defcon_badge_main/defcon_badge_main.kicad_pcb (continued)

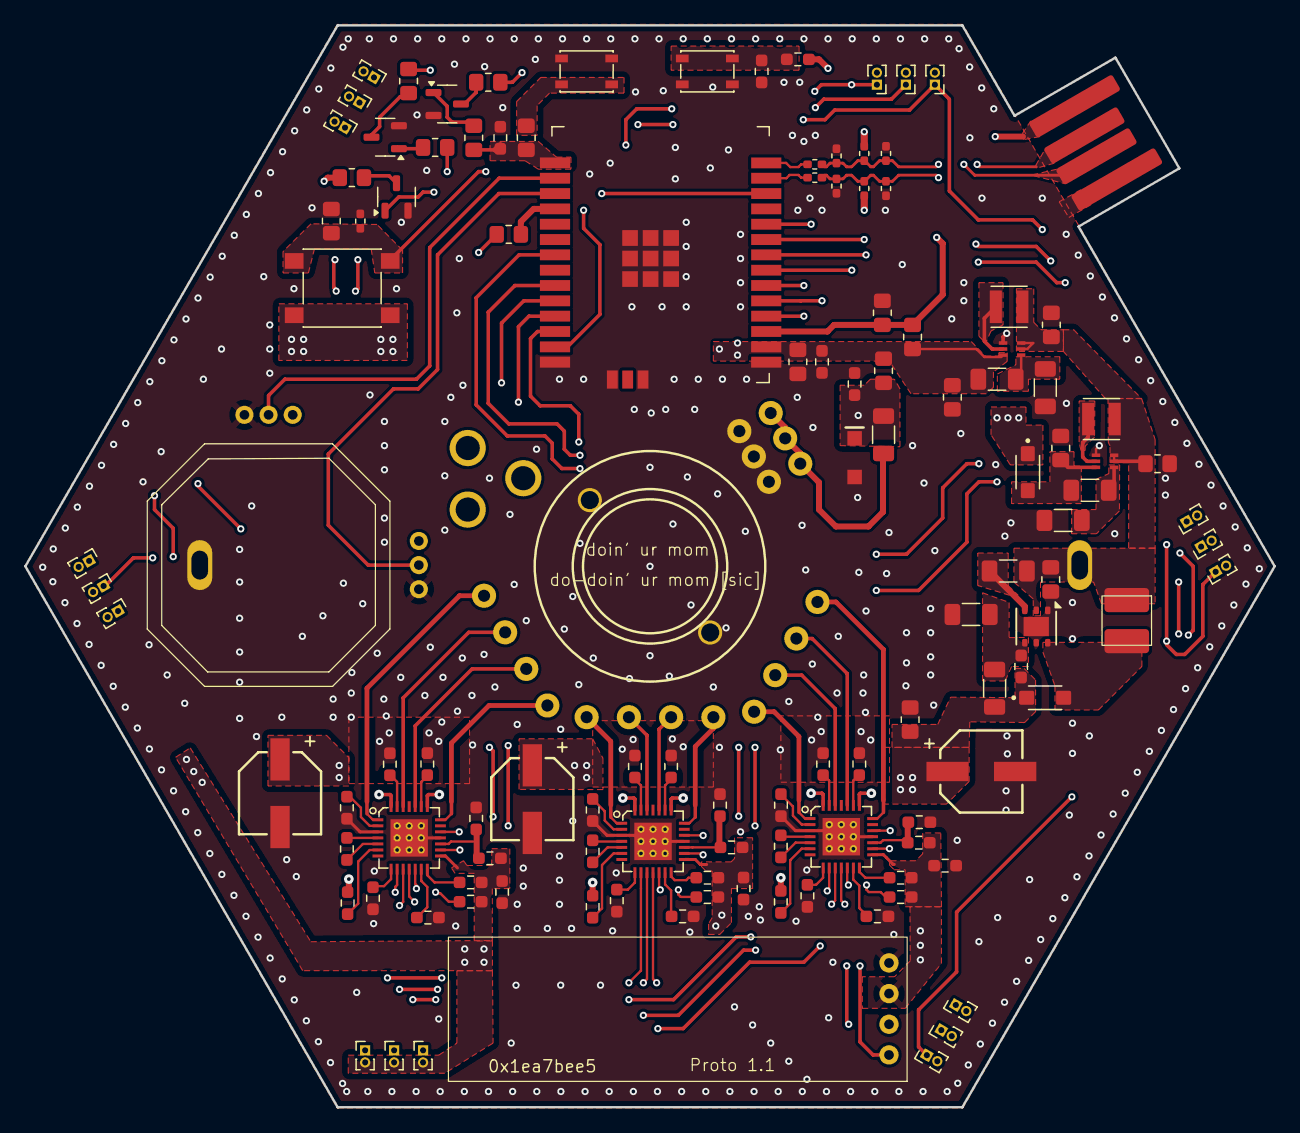
[picture p21: board defcon_badge_main.kicad_pcb from above]

Board: 4 copper layers, 103.5 x 89.6 mm, 127 parts (1 on the bottom side), 93 nets.
