0x1ea7bee5/defcon_badge_2026/(commit log)

2026-02-21 initial project
    [ESP32-C5-WROOM-1U PCB Footprint_0.dxf, ESP32-C5-WROOM-1U_V1_1_20250619_0.STEP, TPS61023DRLR.STEP, TPS61023DRLR.step, defcon_badge_main.kicad_pcb, defcon_badge_main.kicad_sch]
2026-02-22 progress from 2_21_26
    [DRIVER-A4988SETTR-T_QFN28_.step, defcon_badge_main.kicad_sch, esp32.kicad_sch, motor_drivers.kicad_sch, power_reg_5v.kicad_sch, power_regulator.kicad_sch]
2026-02-23 schematic complete
    [SS24FL.step, WCAP-ASLI_6.3X5.5.step]
2026-02-23 Fixed footprint and naming issues
    [1043P.step]
2026-02-24 ESP32 test board layout
    [8v_power.kicad_sch, defcon_badge_main.kicad_pcb, defcon_badge_main.kicad_sch, defcon_badge_proto_ESP.kicad_pcb, esp32.kicad_sch, led.kicad_sch, limit_switch.kicad_sch, motor_drivers.kicad_sch]
2026-02-26 begin full layout
    [defcon_badge_main.kicad_pcb, defcon_badge_proto_ESP.kicad_pcb, esp32.kicad_sch, led.kicad_sch, motor_drivers.kicad_sch]
2026-03-02 more layout
    [8v_power.kicad_sch, defcon_badge_main.kicad_pcb, defcon_badge_main.kicad_sch, esp32.kicad_sch, led.kicad_sch, limit_switch.kicad_sch, motor_drivers.kicad_sch, power_reg_5v.kicad_sch]
2026-03-07 moar layout
    [10164359-00011LF.step, defcon_badge_main.kicad_pcb, defcon_badge_main.kicad_sch, esp32.kicad_sch, led.kicad_sch, power_reg_5v.kicad_sch]
2026-04-26 added component parts and modifications
    [8v_power.kicad_sch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]
2026-06-07 Started adding software
    [defcon_badge_main.kicad_pcb, defcon_badge_main.stl]
